eic/epic-data/onnx/identity_gemm_w1x1_b1.onnx.png

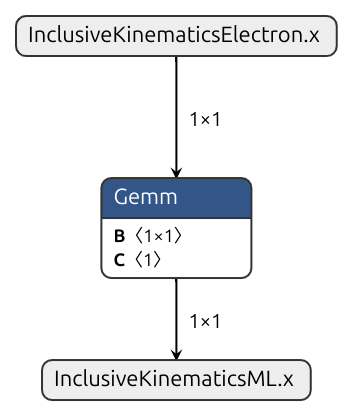
onnx/identity_gemm_w1x1_b1.onnx.png
