eic/epic-data/barrel_HCAL_gdml/ePIC_BarrelHCAL_Full_NoCombs_preMesh.FCStd

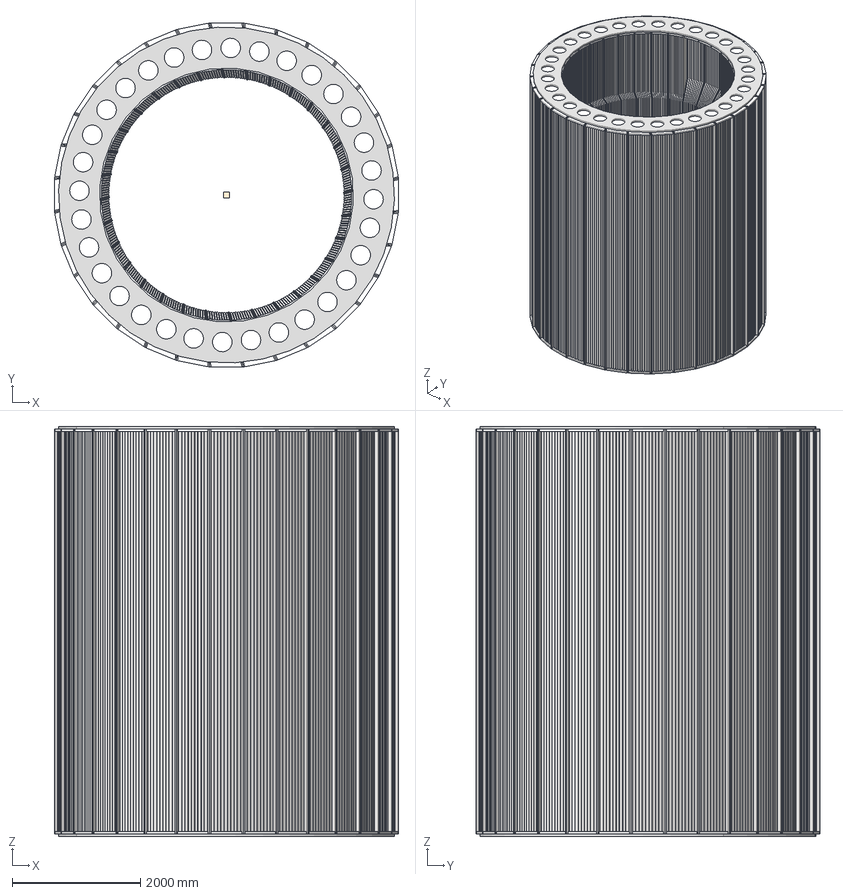
[picture p2: CAD file, 2024-01-17]
barrel_HCAL_gdml/ePIC_BarrelHCAL_Full_NoCombs_preMesh.FCStd
5364.5 x 5364.5 x 6393.4 mm
GDMLBox_WorldBox
Outer HCal Absorber Plate_Mod.stp.STEP
Outer HCal Absorber Plate_Mod.stp.STEP001
Outer HCal Absorber Plate_Mod.stp.STEP002
Outer HCal Absorber Plate_Mod.stp.STEP003
Outer HCal Absorber Plate_Mod.stp.STEP004
Outer HCal Absorber Plate_Mod.stp.STEP005
Outer HCal Absorber Plate_Mod.stp.STEP006
Outer HCal Absorber Plate_Mod.stp.STEP007
Outer HCal Absorber Plate_Mod.stp.STEP008
Outer HCal Half Absorber Plate A_Mod.stp.STEP
Outer HCal Half Absorber Plate B_Mod.stp.STEP
Outer HCal End Plate A_Mod.stp.STEP
Outer HCal End Plate B_Mod.stp.STEP
Outer HCal Absorber Plate_Mod.stp.STEP009
Outer HCal Absorber Plate_Mod.stp.STEP010
Outer HCal Absorber Plate_Mod.stp.STEP011
Outer HCal Absorber Plate_Mod.stp.STEP012
Outer HCal Absorber Plate_Mod.stp.STEP013
Outer HCal Absorber Plate_Mod.stp.STEP014
Outer HCal Absorber Plate_Mod.stp.STEP015
Outer HCal Absorber Plate_Mod.stp.STEP016
Outer HCal Absorber Plate_Mod.stp.STEP017
Outer HCal Half Absorber Plate A_Mod.stp.STEP001
Outer HCal Half Absorber Plate B_Mod.stp.STEP001
Outer HCal End Plate A_Mod.stp.STEP001
Outer HCal End Plate B_Mod.stp.STEP001
Outer HCal Absorber Plate_Mod.stp.STEP018
Outer HCal Absorber Plate_Mod.stp.STEP019
Outer HCal Absorber Plate_Mod.stp.STEP020
Outer HCal Absorber Plate_Mod.stp.STEP021
Outer HCal Absorber Plate_Mod.stp.STEP022
Outer HCal Absorber Plate_Mod.stp.STEP023
Outer HCal Absorber Plate_Mod.stp.STEP024
Outer HCal Absorber Plate_Mod.stp.STEP025
Outer HCal Absorber Plate_Mod.stp.STEP026
Outer HCal Half Absorber Plate A_Mod.stp.STEP002
Outer HCal Half Absorber Plate B_Mod.stp.STEP002
Outer HCal End Plate A_Mod.stp.STEP002
Outer HCal End Plate B_Mod.stp.STEP002
Outer HCal Absorber Plate_Mod.stp.STEP027
Outer HCal Absorber Plate_Mod.stp.STEP028
Outer HCal Absorber Plate_Mod.stp.STEP029
Outer HCal Absorber Plate_Mod.stp.STEP030
Outer HCal Absorber Plate_Mod.stp.STEP031
Outer HCal Absorber Plate_Mod.stp.STEP032
Outer HCal Absorber Plate_Mod.stp.STEP033
Outer HCal Absorber Plate_Mod.stp.STEP034
Outer HCal Absorber Plate_Mod.stp.STEP035
Outer HCal Half Absorber Plate A_Mod.stp.STEP003
Outer HCal Half Absorber Plate B_Mod.stp.STEP003
Outer HCal End Plate A_Mod.stp.STEP003
Outer HCal End Plate B_Mod.stp.STEP003
Outer HCal Absorber Plate_Mod.stp.STEP036
Outer HCal Absorber Plate_Mod.stp.STEP037
Outer HCal Absorber Plate_Mod.stp.STEP038
Outer HCal Absorber Plate_Mod.stp.STEP039
Outer HCal Absorber Plate_Mod.stp.STEP040
Outer HCal Absorber Plate_Mod.stp.STEP041
Outer HCal Absorber Plate_Mod.stp.STEP042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
