eic/epic-data/barrel_HCAL_gdml/ePIC_BarrelHCAL_Sector_NoCombs_Union_preMesh.FCStd

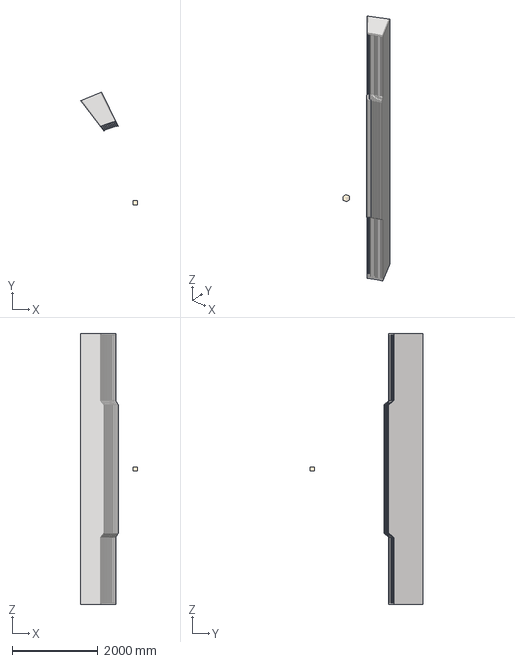
[picture p4: CAD file, 2024-02-16]
barrel_HCAL_gdml/ePIC_BarrelHCAL_Sector_NoCombs_Union_preMesh.FCStd
1319.6 x 2628.8 x 6316.2 mm
GDMLBox_WorldBox
