eic/epic-data/SVTOB_gdml/L3/2026-01-14_L3_Stave_for_Sims.step

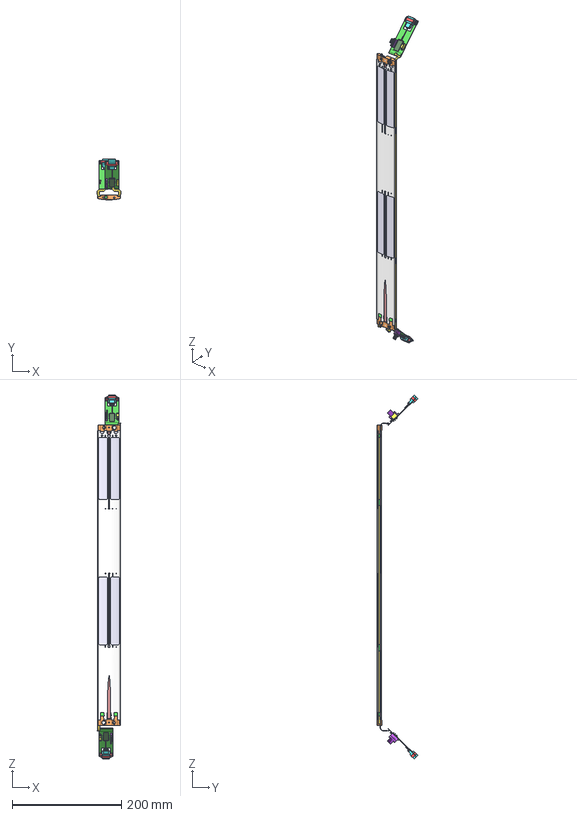
[picture p6: CAD file, 2026-10-30]
SVTOB_gdml/L3/2026-01-14_L3_Stave_for_Sims.step
44.2 x 74.6 x 666.2 mm
Carbon Compsite Central Spar_L3 x 2
K9 Split CrossBrace_L3 End x 2
K9 Split CrossBrace_L3 x 4
K9 Split CrossBrace_Sensor 4-077 x 2
MirrorK9 Split CrossBrace1_L3 End
Ultem End Mount_Square_Captive_Mod for C channel Longeron072 x 2
MirrorK9 Split CrossBrace2_L3 End
FPC Mockup L3_L3 Full x 2
Carbon Composite Stave Skin L3_updated_Bottom
Carbon Composite Stave Skin L3_updated_Top
CAPC0603X33N_3.step x 2
CAPC0603X33N001_3.step x 2
CAPC0603X33N002_3.step x 2
CAPC0603X33N004_2.step x 2
CAPC0603X33N005_3.step x 2
CAPC0603X33N006_2.step x 2
CAPC0603X33N008_3.step x 2
CAPC0603X33N009_3.step x 2
CAPC0603X33N010_3.step x 2
CAPC0603X33N012_2.step x 2
CAPC0603X33N013_3.step x 2
CAPC0603X33N014_3.step x 2
RESC0603X28N_3.step x 2
RESC0603X28N001_3.step x 2
RESC0603X28N002_3.step x 2
CAPC0603X33N016_3.step x 2
CAPC0603X33N017_2.step x 2
CAPC0603X33N018_3.step x 2
CAPC0603X33N020_3.step x 2
CAPC0603X33N021_3.step x 2
CAPC0603X33N022_3.step x 2
CAPC0603X33N024_3.step x 2
CAPC0603X33N025_3.step x 2
CAPC0603X33N026_3.step x 2
DF40C-40DP_3.step x 2
CAPC1005X55N_3.step x 2
CAPC1005X55N001_3.step x 2
CAPC1005X55N002_3.step x 2
CAPC1005X55N004_3.step x 2
CAPC1005X55N005_3.step x 2
CAPC1005X55N006_3.step x 2
CAPC0603X33N028_3.step x 2
CAPC0603X33N029_3.step x 2
CAPC0603X33N030_3.step x 2
CAPC0603X33N032_3.step x 2
CAPC0603X33N033_3.step x 2
CAPC0603X33N034_3.step x 2
CAPC0603X33N036_3.step x 2
CAPC0603X33N037_3.step x 2
CAPC0603X33N038_3.step x 2
CAPC1005X55N008_3.step x 2
CAPC1005X55N009_3.step x 2
CAPC1005X55N010_3.step x 2
Board_3.step x 2
Opto_3.step x 2
Pigtail_3.step x 2
Pigtail001_3.step x 2
Pigtail002_3.step x 2
Pigtail003_3.step x 2
Pigtail004_3.step x 2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
