eic/epic-data/barrel_HCAL_gdml/ePIC_BarrelHCAL_Sector_NoCombs_Union_Meshed.FCStd

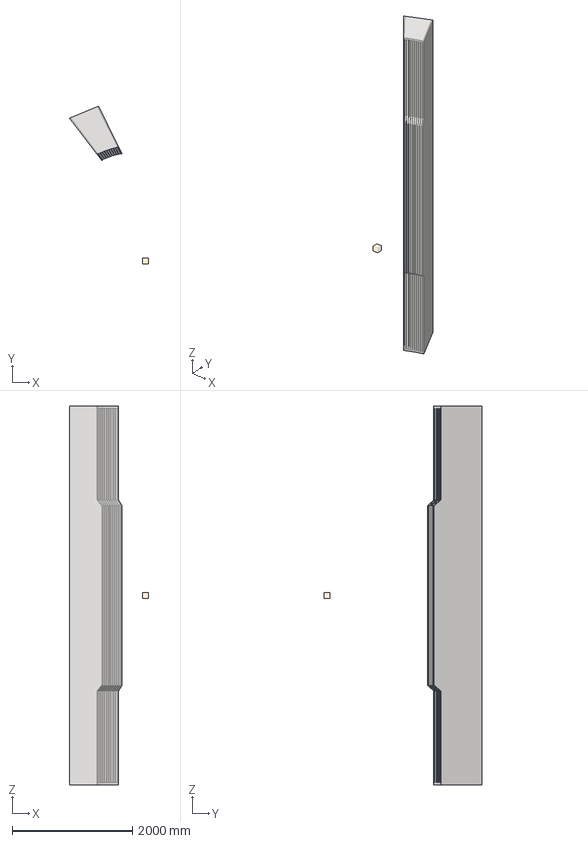
[picture p7: CAD file, 2024-02-16]
barrel_HCAL_gdml/ePIC_BarrelHCAL_Sector_NoCombs_Union_Meshed.FCStd
1319.6 x 2628.8 x 6316.2 mm
GDMLBox_WorldBox
GDMLTessellate_Mesh2Tess
