eic/epic-data/barrel_HCAL_gdml/tiles/Outer HCAL Tile 6 Fiber - South 10-20-2022.stp

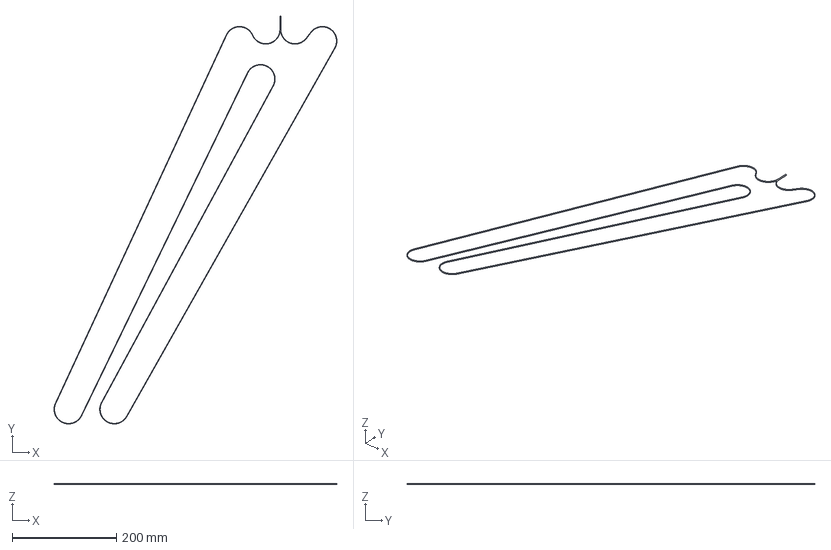
[picture p8: CAD file, 2024-02-11]
barrel_HCAL_gdml/tiles/Outer HCAL Tile 6 Fiber - South 10-20-2022.stp
542.7 x 782.3 x 2.10 mm
