eic/epic-data/barrel_HCAL_gdml/ePIC_BarrelHCAL_ChimneySector_NoCombs_Union_preMesh.FCStd

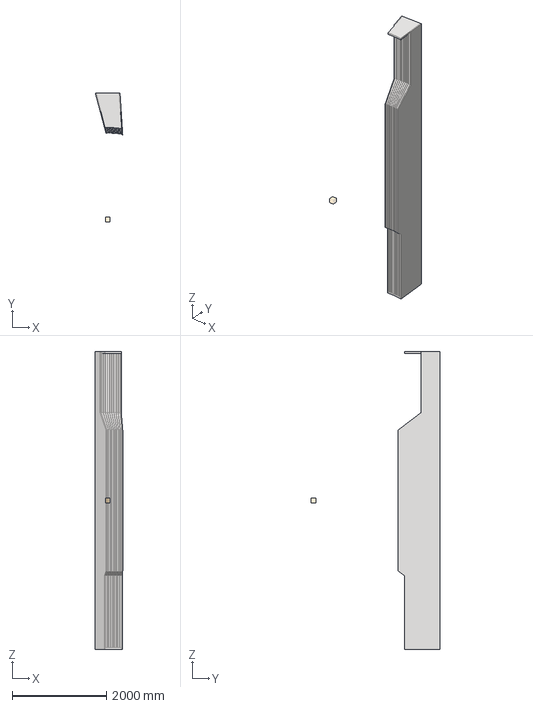
[picture p9: CAD file, 2024-02-16]
barrel_HCAL_gdml/ePIC_BarrelHCAL_ChimneySector_NoCombs_Union_preMesh.FCStd
583.6 x 2732.3 x 6316.2 mm
GDMLBox_WorldBox
