eic/epic-data/barrel_HCAL_gdml/tiles/Outer HCAL Tile 2 Fiber - South10-19-2022.stp

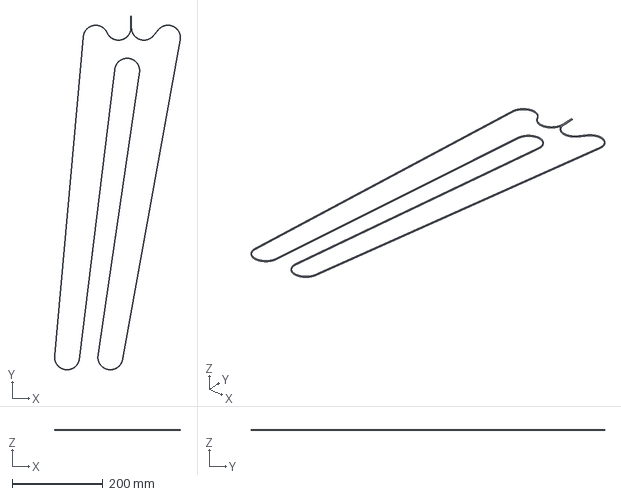
[picture p10: CAD file, 2024-02-11]
barrel_HCAL_gdml/tiles/Outer HCAL Tile 2 Fiber - South10-19-2022.stp
279.0 x 782.3 x 2.10 mm
