eic/epic-data/barrel_HCAL_gdml/2021MAY12_sPHENIX_CM_ChimneySector_NoCombs.STEP

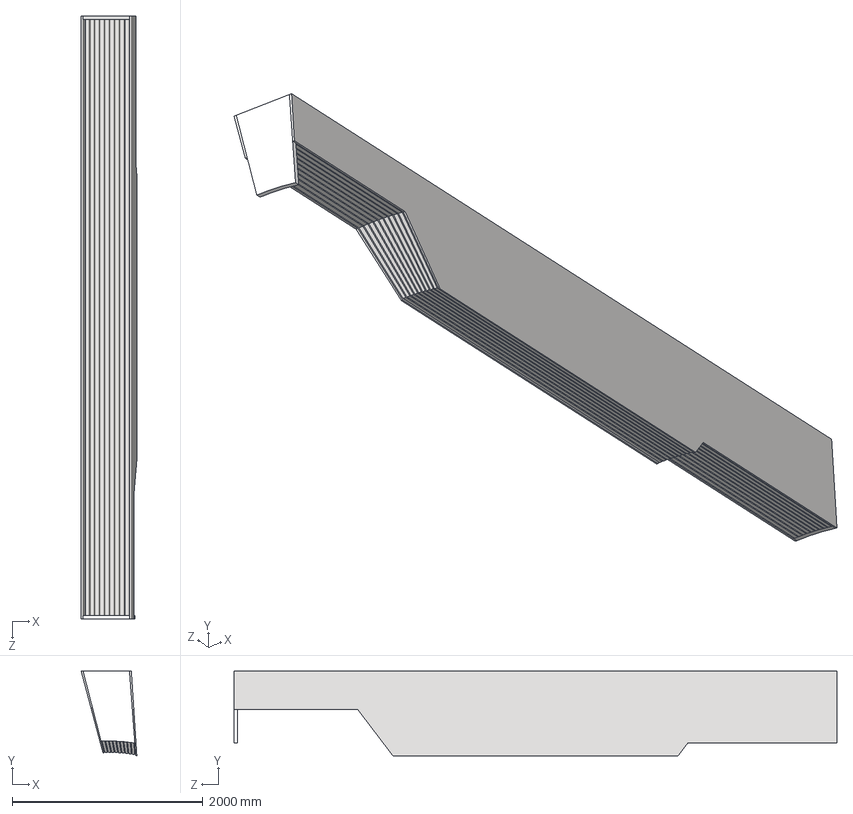
[picture p11: CAD file, 2024-02-16]
barrel_HCAL_gdml/2021MAY12_sPHENIX_CM_ChimneySector_NoCombs.STEP
583.6 x 886.5 x 6316.2 mm
Chimney HCal Absorber Plate_Mod.stp.STEP.STEP x 9
Chimney HCal Half Absorber Plate A_Mod.stp.STEP.STEP
Chimney HCal Half Absorber Plate B_Mod.stp.STEP.STEP
Outer HCal End Plate A_Mod.stp.STEP.STEP
Outer HCal End Plate B_Mod.stp.STEP.STEP
