eic/epic-data/barrel_HCAL_gdml/2021MAY12_sPHENIX_CM_Sector_NoCombs.STEP

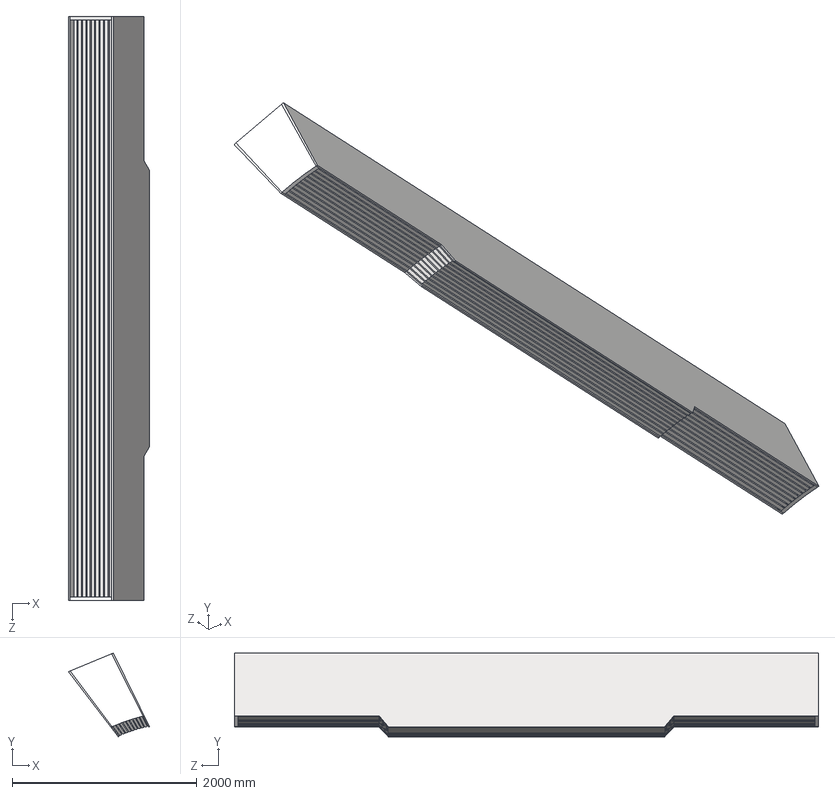
[picture p13: CAD file, 2024-02-16]
barrel_HCAL_gdml/2021MAY12_sPHENIX_CM_Sector_NoCombs.STEP
878.4 x 906.8 x 6316.2 mm
Outer HCal Absorber Plate_Mod.stp.STEP.STEP x 9
Outer HCal Half Absorber Plate A_Mod.stp.STEP.STEP
Outer HCal Half Absorber Plate B_Mod.stp.STEP.STEP
Outer HCal End Plate A_Mod.stp.STEP.STEP
Outer HCal End Plate B_Mod.stp.STEP.STEP
