eic/epic-data/barrel_HCAL_gdml/tiles/Outer HCAL Chimney Tile 11  Fiber  - South 10-20-2022.stp

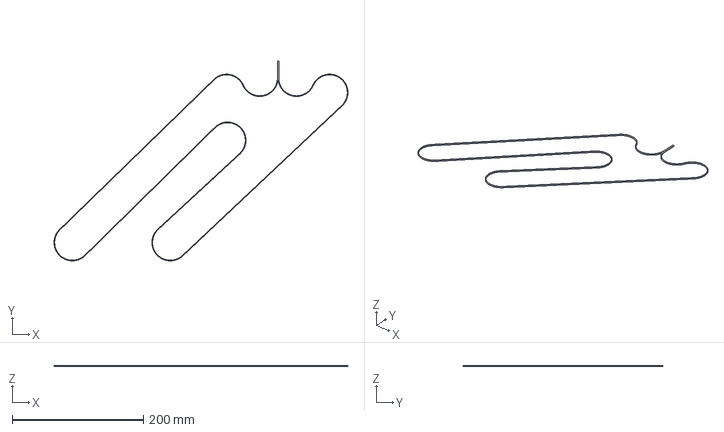
[picture p14: CAD file, 2024-02-11]
barrel_HCAL_gdml/tiles/Outer HCAL Chimney Tile 11 Fiber - South 10-20-2022.stp
448.2 x 304.7 x 2.10 mm
