eic/epic-data/barrel_HCAL_gdml/tiles/Outer HCAL Tile 1 Body  - North10-19-2022.stp

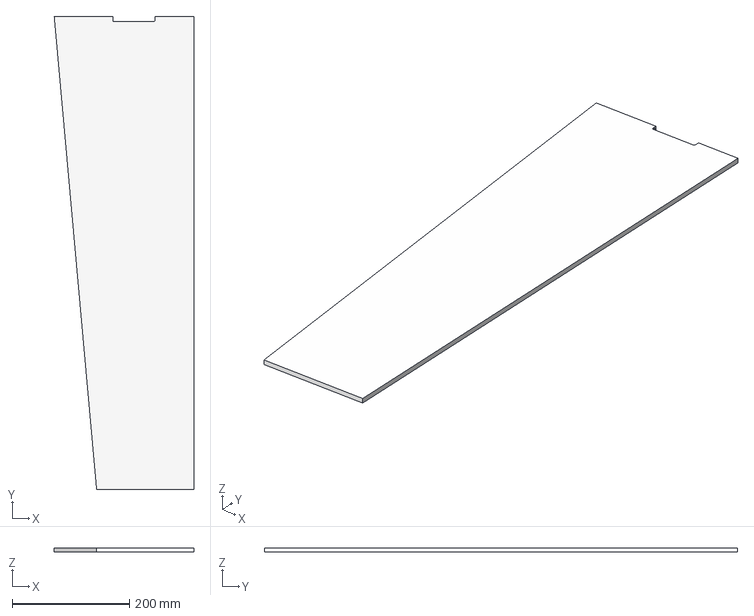
[picture p15: CAD file, 2024-02-11]
barrel_HCAL_gdml/tiles/Outer HCAL Tile 1 Body - North10-19-2022.stp
238.5 x 808.3 x 7.00 mm
