eic/epic-data/barrel_HCAL_gdml/ePIC_BarrelHCAL_EndRing_preMesh.FCStd

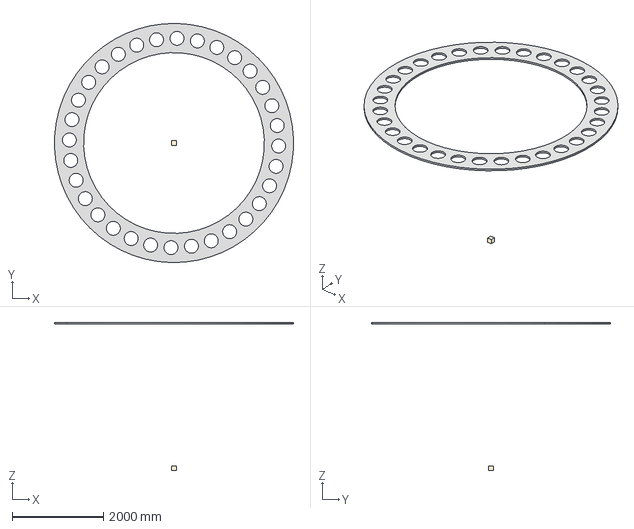
[picture p16: CAD file, 2024-02-16]
barrel_HCAL_gdml/ePIC_BarrelHCAL_EndRing_preMesh.FCStd
5236.9 x 5238.5 x 3247.7 mm
GDMLBox_WorldBox
SIMPL_RING_1.stp.STEP.STEP
