eic/epic-data/barrel_HCAL_gdml/tiles/Outer HCAL Tile 5 Body - North10-20-2022.stp

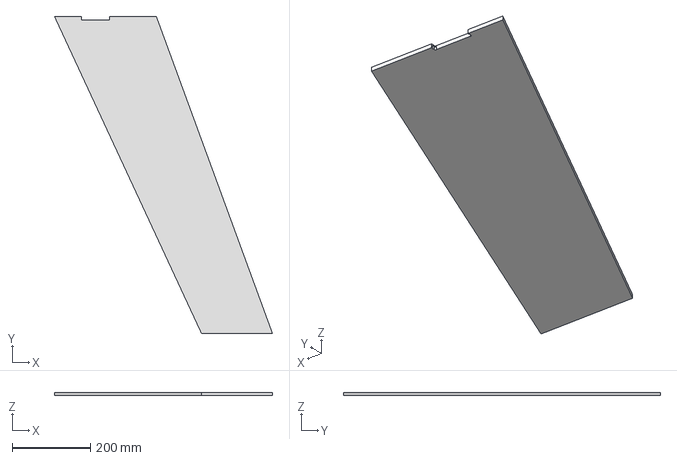
[picture p17: CAD file, 2024-02-11]
barrel_HCAL_gdml/tiles/Outer HCAL Tile 5 Body - North10-20-2022.stp
556.0 x 808.3 x 7.00 mm
