eic/epic-data/barrel_HCAL_gdml/tiles/Outer HCAL Tile 3 Fiber  - North10-20-2022.stp

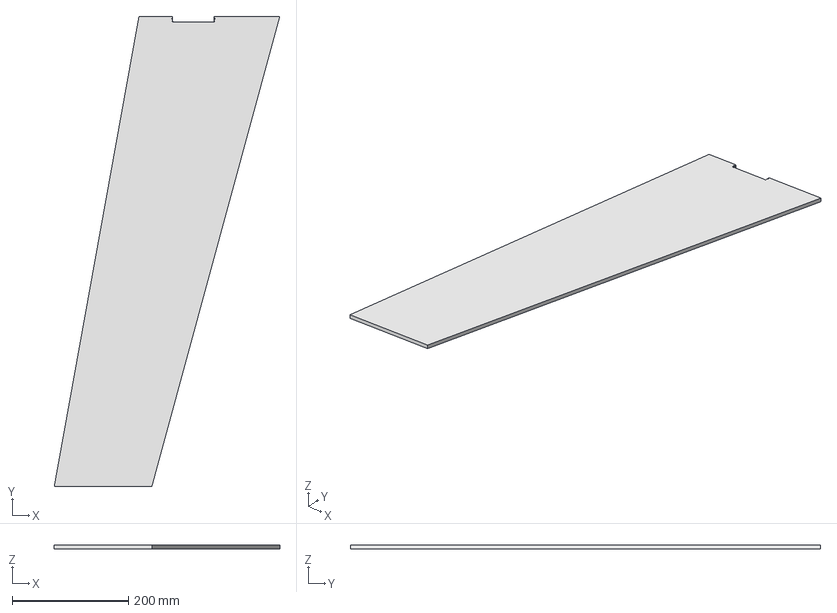
[picture p19: CAD file, 2024-02-11]
barrel_HCAL_gdml/tiles/Outer HCAL Tile 3 Fiber - North10-20-2022.stp
387.9 x 808.3 x 7.00 mm
