eic/epic-data/barrel_HCAL_gdml/tiles/Outer HCAL Tile 10  Fiber  - North10-20-2022.stp

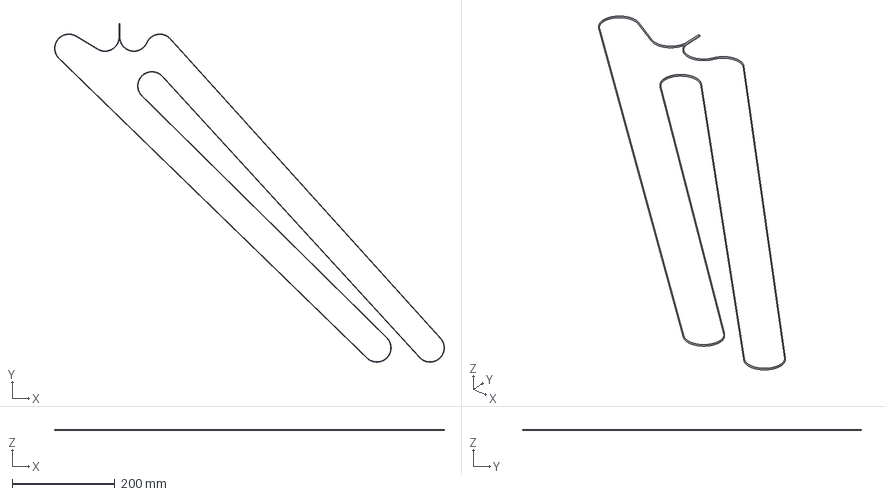
[picture p20: CAD file, 2024-02-11]
barrel_HCAL_gdml/tiles/Outer HCAL Tile 10 Fiber - North10-20-2022.stp
758.4 x 658.4 x 2.10 mm
