eic/epic-data/barrel_HCAL_gdml/2021MAY12_sPHENIX_CM_EndRing.STEP

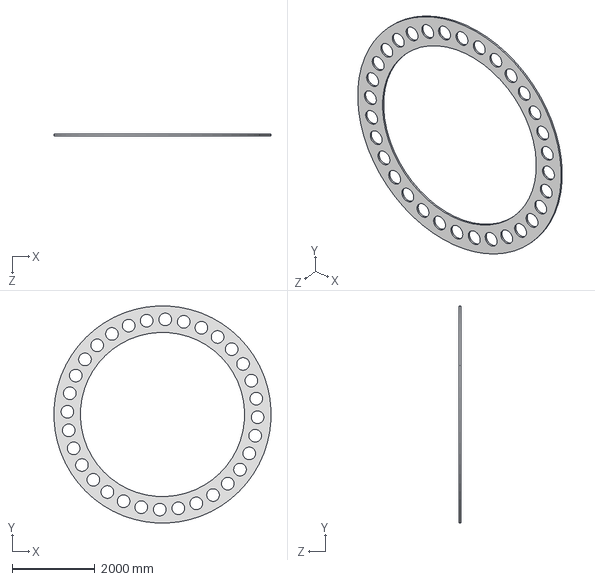
[picture p21: CAD file, 2024-02-16]
barrel_HCAL_gdml/2021MAY12_sPHENIX_CM_EndRing.STEP
5233.9 x 5233.9 x 38.6 mm
