eic/epic-data/barrel_HCAL_gdml/tiles/Outer HCAL Tile 12  Fiber  - North10-20-2022.stp

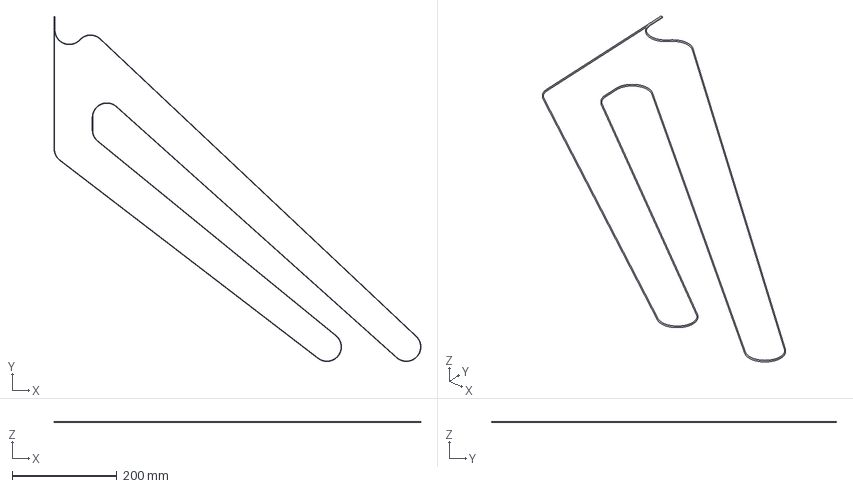
[picture p22: CAD file, 2024-02-11]
barrel_HCAL_gdml/tiles/Outer HCAL Tile 12 Fiber - North10-20-2022.stp
700.1 x 658.4 x 2.10 mm
