eic/epic-data/barrel_HCAL_gdml/ePIC_BarrelHCAL_Plates_EndPlates_Only_Union_preMesh.FCStd

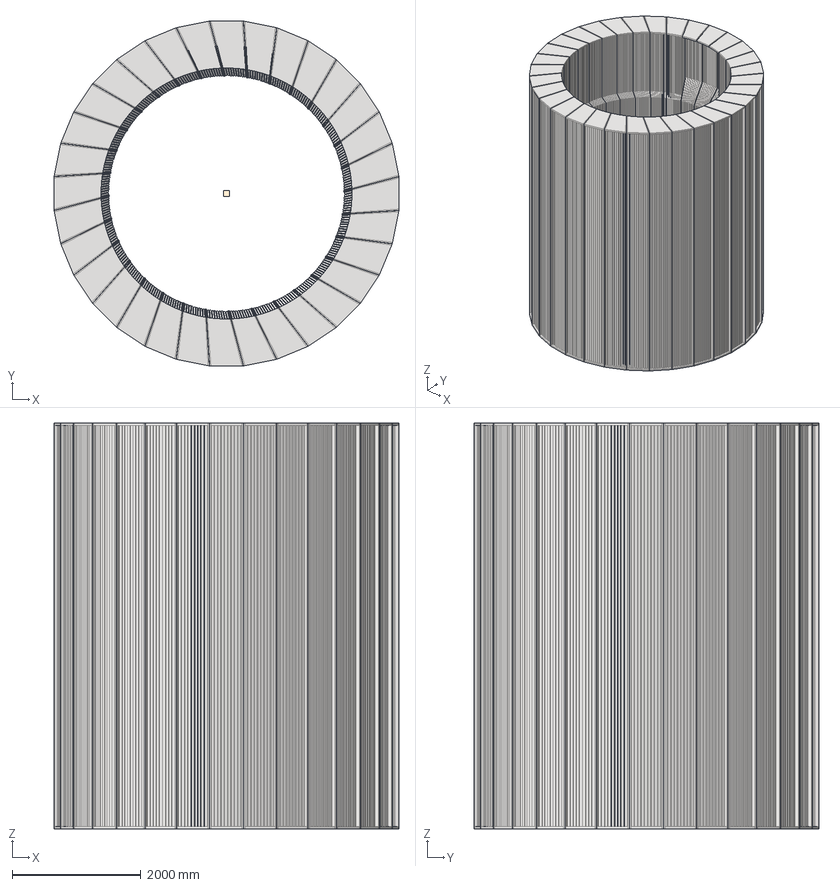
[picture p23: CAD file, 2024-01-17]
barrel_HCAL_gdml/ePIC_BarrelHCAL_Plates_EndPlates_Only_Union_preMesh.FCStd
5364.5 x 5364.5 x 6316.2 mm
GDMLBox_WorldBox
