eic/epic-data/barrel_HCAL_gdml/tiles/Outer HCAL Tile 9  Body - North10-20-2022.stp

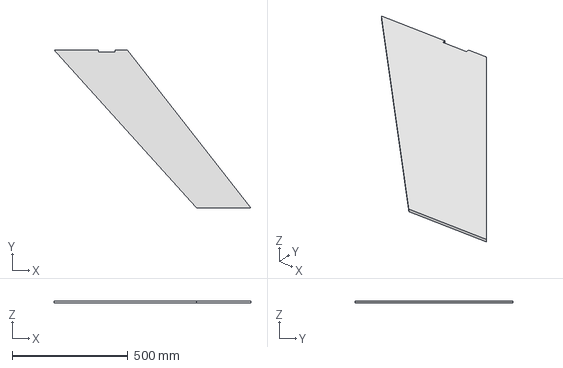
[picture p25: CAD file, 2024-02-11]
barrel_HCAL_gdml/tiles/Outer HCAL Tile 9 Body - North10-20-2022.stp
852.3 x 684.4 x 7.00 mm
