eic/epic-data/barrel_HCAL_gdml/tiles/Outer HCAL Tile 4 Fiber  - North10-20-2022.stp

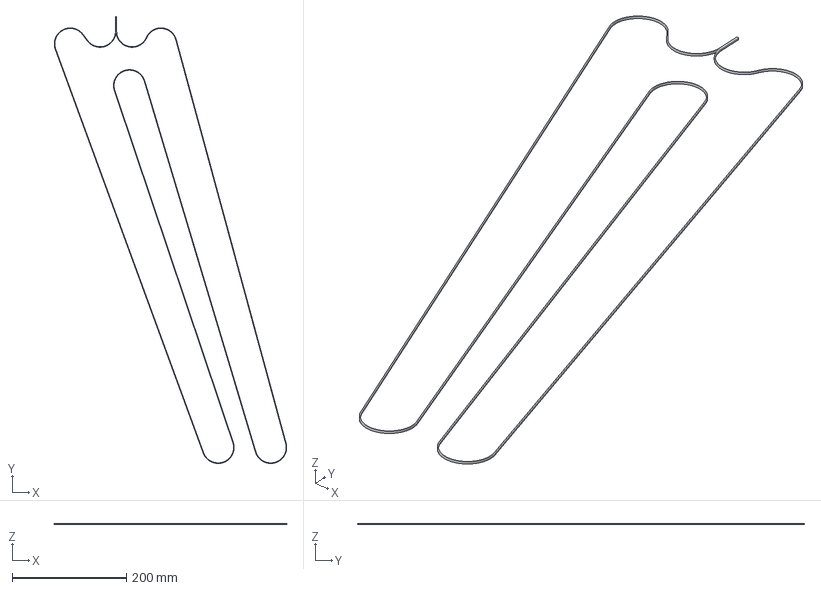
[picture p26: CAD file, 2024-02-11]
barrel_HCAL_gdml/tiles/Outer HCAL Tile 4 Fiber - North10-20-2022.stp
406.9 x 782.3 x 2.10 mm
