eic/epic-data/barrel_HCAL_gdml/tiles/Outer HCAL Tile 2 Body  - North10-19-2022.stp

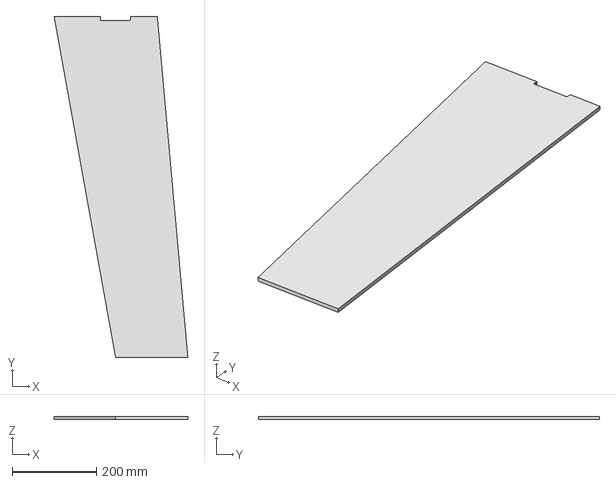
[picture p27: CAD file, 2024-02-11]
barrel_HCAL_gdml/tiles/Outer HCAL Tile 2 Body - North10-19-2022.stp
317.1 x 808.3 x 7.00 mm
