eic/epic-data/barrel_HCAL_gdml/tiles/Outer HCAL Tile 7  Fiber  - South 10-20-2022.stp

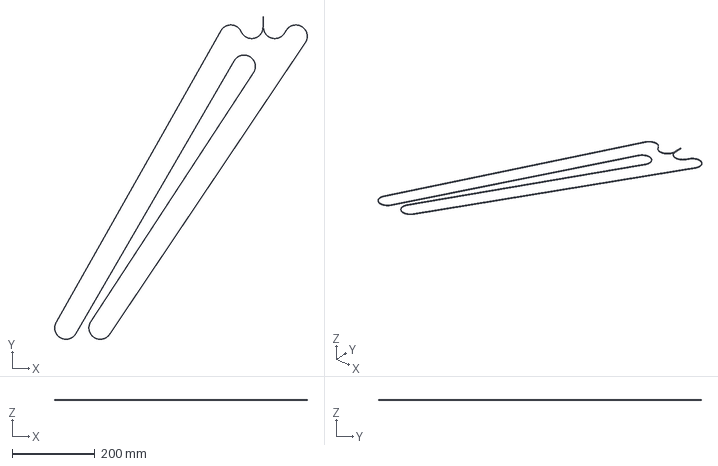
[picture p30: CAD file, 2024-02-11]
barrel_HCAL_gdml/tiles/Outer HCAL Tile 7 Fiber - South 10-20-2022.stp
612.8 x 782.3 x 2.10 mm
