eic/epic-data/barrel_HCAL_gdml/tiles/Outer HCAL Tile 8  Body - North10-20-2022.stp

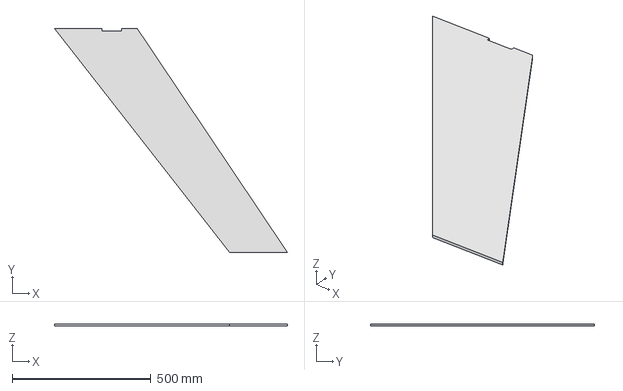
[picture p33: CAD file, 2024-02-11]
barrel_HCAL_gdml/tiles/Outer HCAL Tile 8 Body - North10-20-2022.stp
841.0 x 808.3 x 7.00 mm
