eic/epic-data/barrel_HCAL_gdml/2021MAY12_sPHENIX_CM_Plates_EndPlates_Only.STEP

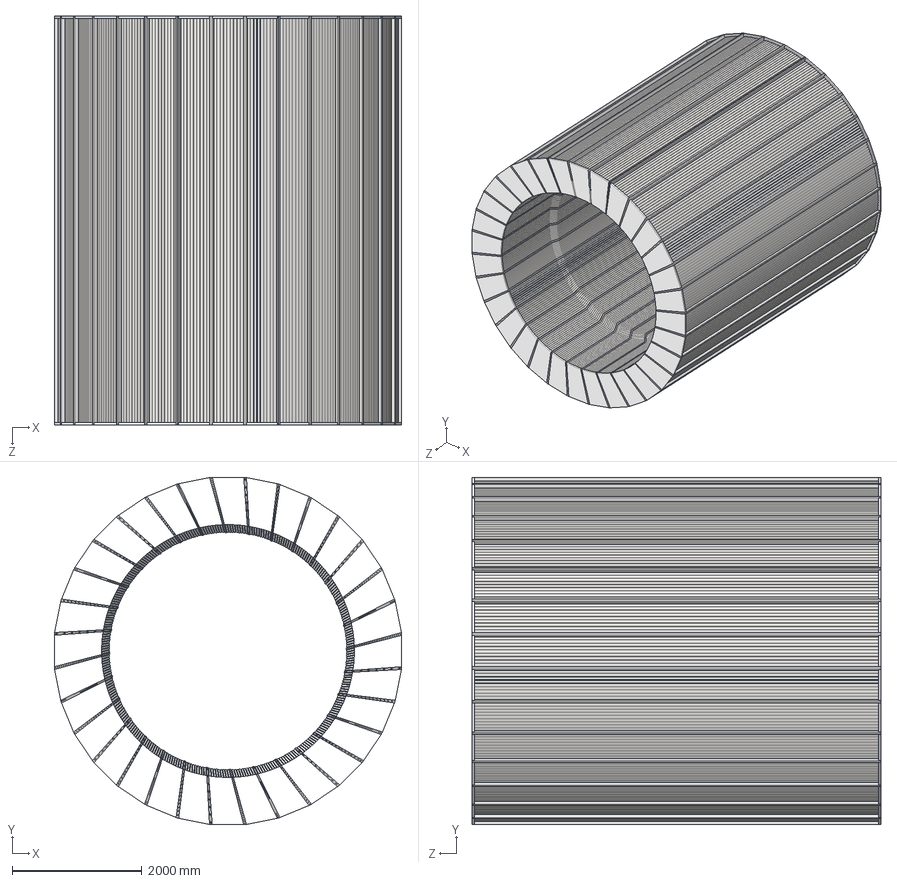
[picture p34: CAD file, 2024-01-04]
barrel_HCAL_gdml/2021MAY12_sPHENIX_CM_Plates_EndPlates_Only.STEP
5364.5 x 5364.5 x 6316.2 mm
Outer HCal Absorber Plate_Mod.stp.STEP x 261
Outer HCal Half Absorber Plate A_Mod.stp.STEP x 29
Outer HCal Half Absorber Plate B_Mod.stp.STEP x 29
Outer HCal End Plate A_Mod.stp.STEP x 32
Outer HCal End Plate B_Mod.stp.STEP x 32
Chimney HCal Absorber Plate_Mod.stp.STEP x 27
Chimney HCal Half Absorber Plate A_Mod.stp.STEP x 3
Chimney HCal Half Absorber Plate B_Mod.stp.STEP x 3
