eic/epic-data/barrel_HCAL_gdml/tiles/Outer HCAL Tile 9  Fiber  - North10-20-2022.stp

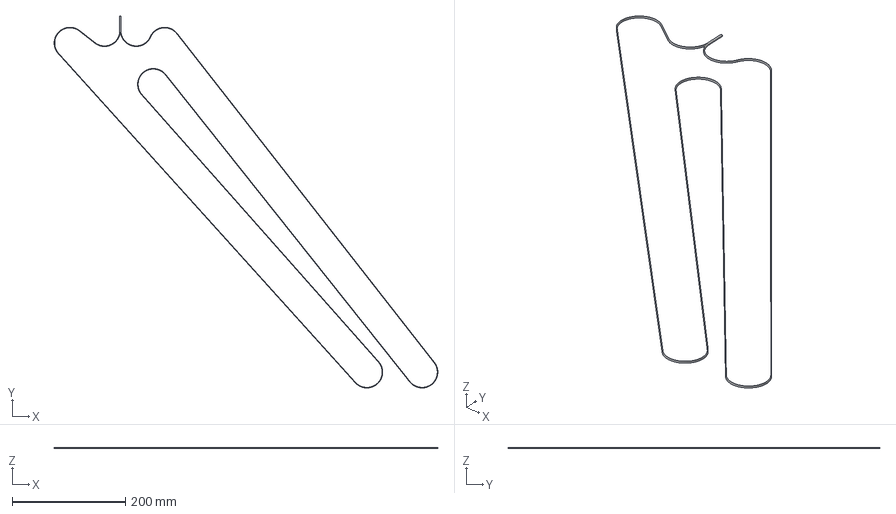
[picture p35: CAD file, 2024-02-11]
barrel_HCAL_gdml/tiles/Outer HCAL Tile 9 Fiber - North10-20-2022.stp
679.2 x 658.4 x 2.10 mm
