eic/epic-data/barrel_HCAL_gdml/tiles/Outer HCAL Tile 10  Body - North10-20-2022.stp

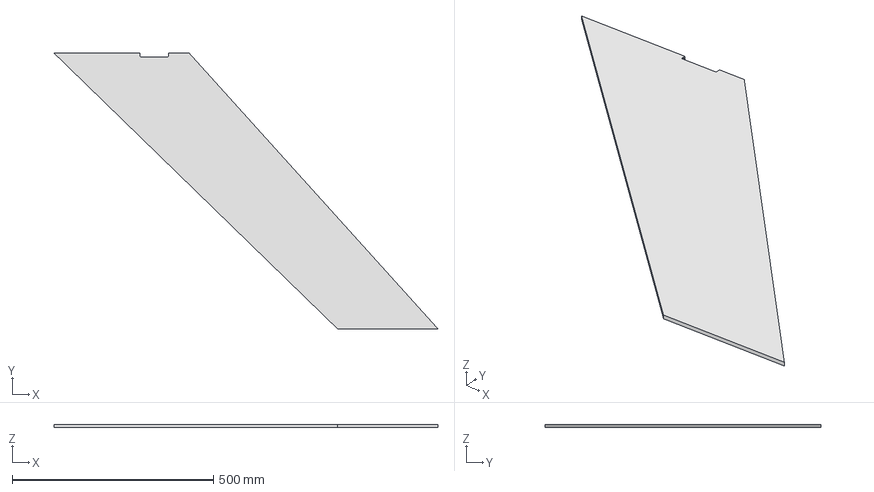
[picture p36: CAD file, 2024-02-11]
barrel_HCAL_gdml/tiles/Outer HCAL Tile 10 Body - North10-20-2022.stp
953.1 x 684.4 x 7.00 mm
