eic/epic-data/barrel_HCAL_gdml/tiles/Outer HCAL Chimney Tile 9  Body - South 10-20-2022.stp

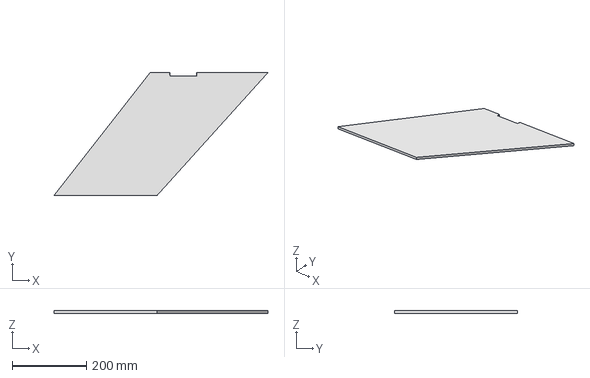
[picture p37: CAD file, 2024-02-11]
barrel_HCAL_gdml/tiles/Outer HCAL Chimney Tile 9 Body - South 10-20-2022.stp
575.7 x 330.7 x 7.00 mm
