eic/epic-data/barrel_HCAL_gdml/tiles/Outer HCAL Chimney Tile 12  Fiber  - South 10-20-2022.stp

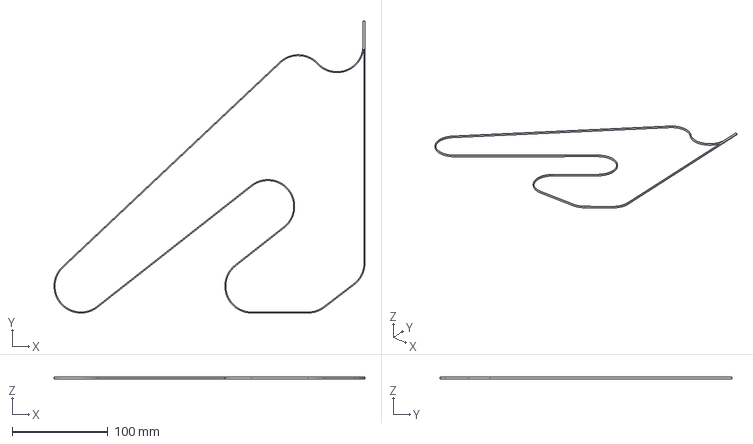
[picture p38: CAD file, 2024-02-11]
barrel_HCAL_gdml/tiles/Outer HCAL Chimney Tile 12 Fiber - South 10-20-2022.stp
324.3 x 304.7 x 2.10 mm
