eic/epic-data/barrel_HCAL_gdml/tiles/Outer HCAL Tile 3 Fiber - South 10-20-2022.stp

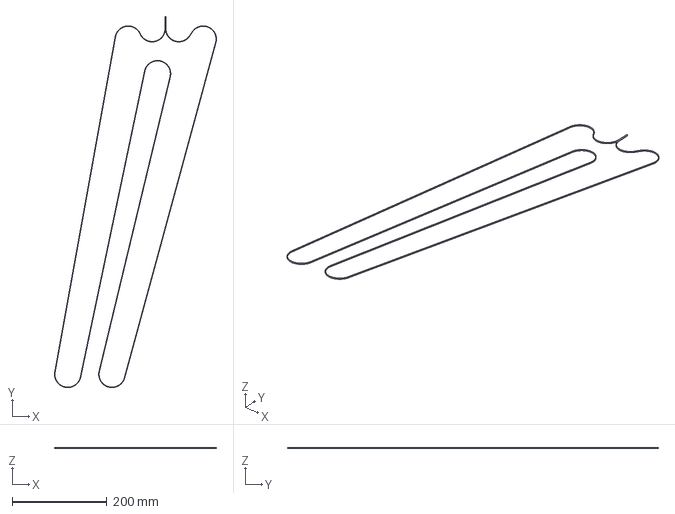
[picture p40: CAD file, 2024-02-11]
barrel_HCAL_gdml/tiles/Outer HCAL Tile 3 Fiber - South 10-20-2022.stp
341.3 x 782.3 x 2.10 mm
