eic/epic-data/barrel_HCAL_gdml/tiles/Outer HCAL Tile 1 Fiber  - South 10-20-2022.stp

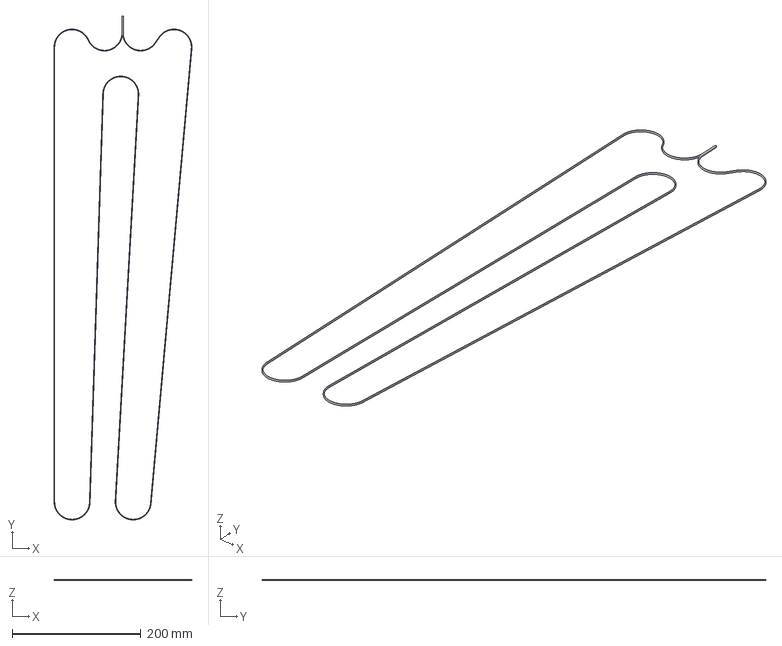
[picture p41: CAD file, 2024-02-11]
barrel_HCAL_gdml/tiles/Outer HCAL Tile 1 Fiber - South 10-20-2022.stp
214.3 x 782.7 x 2.10 mm
