eic/epic-data/barrel_HCAL_gdml/tiles/Outer HCAL Tile 11  Fiber  - North10-20-2022.stp

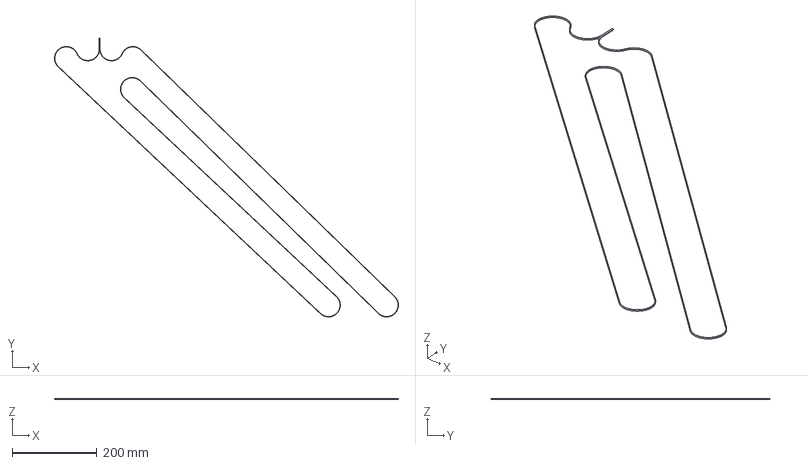
[picture p42: CAD file, 2024-02-11]
barrel_HCAL_gdml/tiles/Outer HCAL Tile 11 Fiber - North10-20-2022.stp
811.9 x 658.4 x 2.10 mm
