eic/epic-data/barrel_HCAL_gdml/tiles/Outer HCAL Tile 12  Body - North10-20-2022.stp

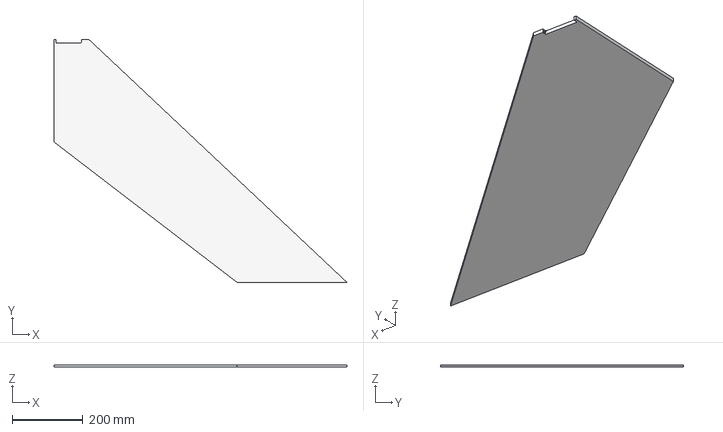
[picture p44: CAD file, 2024-02-11]
barrel_HCAL_gdml/tiles/Outer HCAL Tile 12 Body - North10-20-2022.stp
825.9 x 684.4 x 7.00 mm
