eic/epic-data/barrel_HCAL_gdml/tiles/Outer HCAL Chimney Tile 11  Body - South 10-20-2022.stp

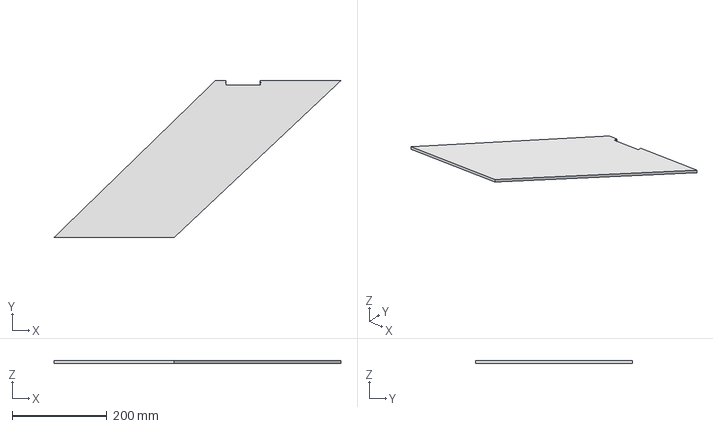
[picture p46: CAD file, 2024-02-11]
barrel_HCAL_gdml/tiles/Outer HCAL Chimney Tile 11 Body - South 10-20-2022.stp
604.7 x 330.7 x 7.00 mm
