eic/epic-data/barrel_HCAL_gdml/tiles/Outer HCAL Chimney Tile 9  Fiber  - South 10-20-2022.stp

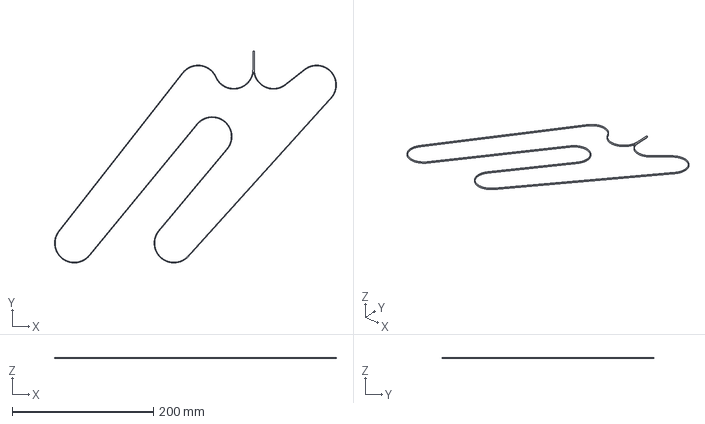
[picture p47: CAD file, 2024-02-11]
barrel_HCAL_gdml/tiles/Outer HCAL Chimney Tile 9 Fiber - South 10-20-2022.stp
398.7 x 299.7 x 2.10 mm
