eic/epic-data/barrel_HCAL_gdml/tiles/Outer HCAL Tile 7  Body  - South 10-20-2022.stp

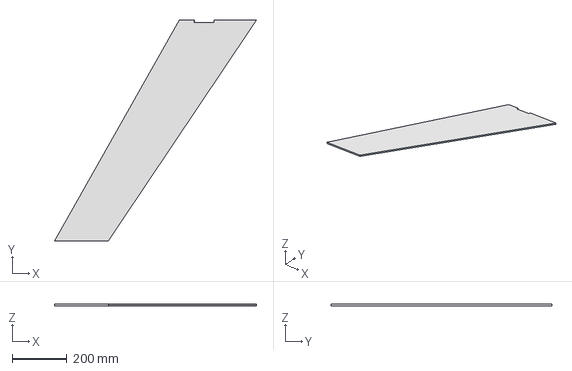
[picture p48: CAD file, 2024-02-11]
barrel_HCAL_gdml/tiles/Outer HCAL Tile 7 Body - South 10-20-2022.stp
739.2 x 808.3 x 7.00 mm
