eic/epic-data/(list of files, cad)

Other CAD files:
barrel_HCAL_gdml/2021MAY12_sPHENIX_CM_Full_NoCombs.STEP
barrel_HCAL_gdml/ePIC_BarrelHCAL_Full_NoCombs_Union_preMesh.FCStd
barrel_HCAL_gdml/ePIC_BarrelHCAL_Sector_NoCombs_preMesh.FCStd
barrel_HCAL_gdml/ePIC_BarrelHCAL_ChimneySector_NoCombs_preMesh.FCStd
barrel_HCAL_gdml/ePIC_BarrelHCAL_Plates_Only_preMesh.FCStd
barrel_HCAL_gdml/tiles/Outer HCAL Tile 3 Body - South 10-20-2022.stp
barrel_HCAL_gdml/2021MAY12_sPHENIX_CM_Plates_Only.STEP
barrel_HCAL_gdml/ePIC_BarrelHCAL_Plates_EndPlates_Only_preMesh.FCStd
barrel_HCAL_gdml/tiles/Outer HCAL Tile 7 Fiber - North10-20-2022.stp
barrel_HCAL_gdml/tiles/Outer HCAL Tile 5 Body - South 10-20-2022.stp
barrel_HCAL_gdml/tiles/Outer HCAL Tile 1 Body - South 10-20-2022.stp
barrel_HCAL_gdml/tiles/Outer HCAL Tile 6 Fiber - North10-20-2022.stp
barrel_HCAL_gdml/tiles/Outer HCAL Tile 2 Fiber - North10-19-2022.stp
barrel_HCAL_gdml/tiles/Outer HCAL Tile 6 Body - North10-20-2022.stp
barrel_HCAL_gdml/tiles/Outer HCAL Tile 4 Fiber - South 10-20-2022.stp
barrel_HCAL_gdml/tiles/Outer HCAL Tile 8 Body - South 10-20-2022.stp
barrel_HCAL_gdml/tiles/Outer HCAL Tile 2 Body - South10-19-2022.stp
barrel_HCAL_gdml/tiles/Outer HCAL Tile 5 Fiber - South 10-20-2022.stp
barrel_HCAL_gdml/tiles/Outer HCAL Tile 1 Fiber - North10-19-2022.stp
barrel_HCAL_gdml/tiles/Outer HCAL Tile 4 Body - South 10-20-2022.stp
barrel_HCAL_gdml/tiles/Outer HCAL Tile 8 Fiber - North10-20-2022.stp
barrel_HCAL_gdml/tiles/Outer HCAL Tile 7 Body - North10-20-2022.stp
barrel_HCAL_gdml/tiles/Outer HCAL Tile 3 Fiber - North10-20-2022.stp
