eic/epic-data/onnx/Low-Q2_Steering_Reconstruction.onnx.png

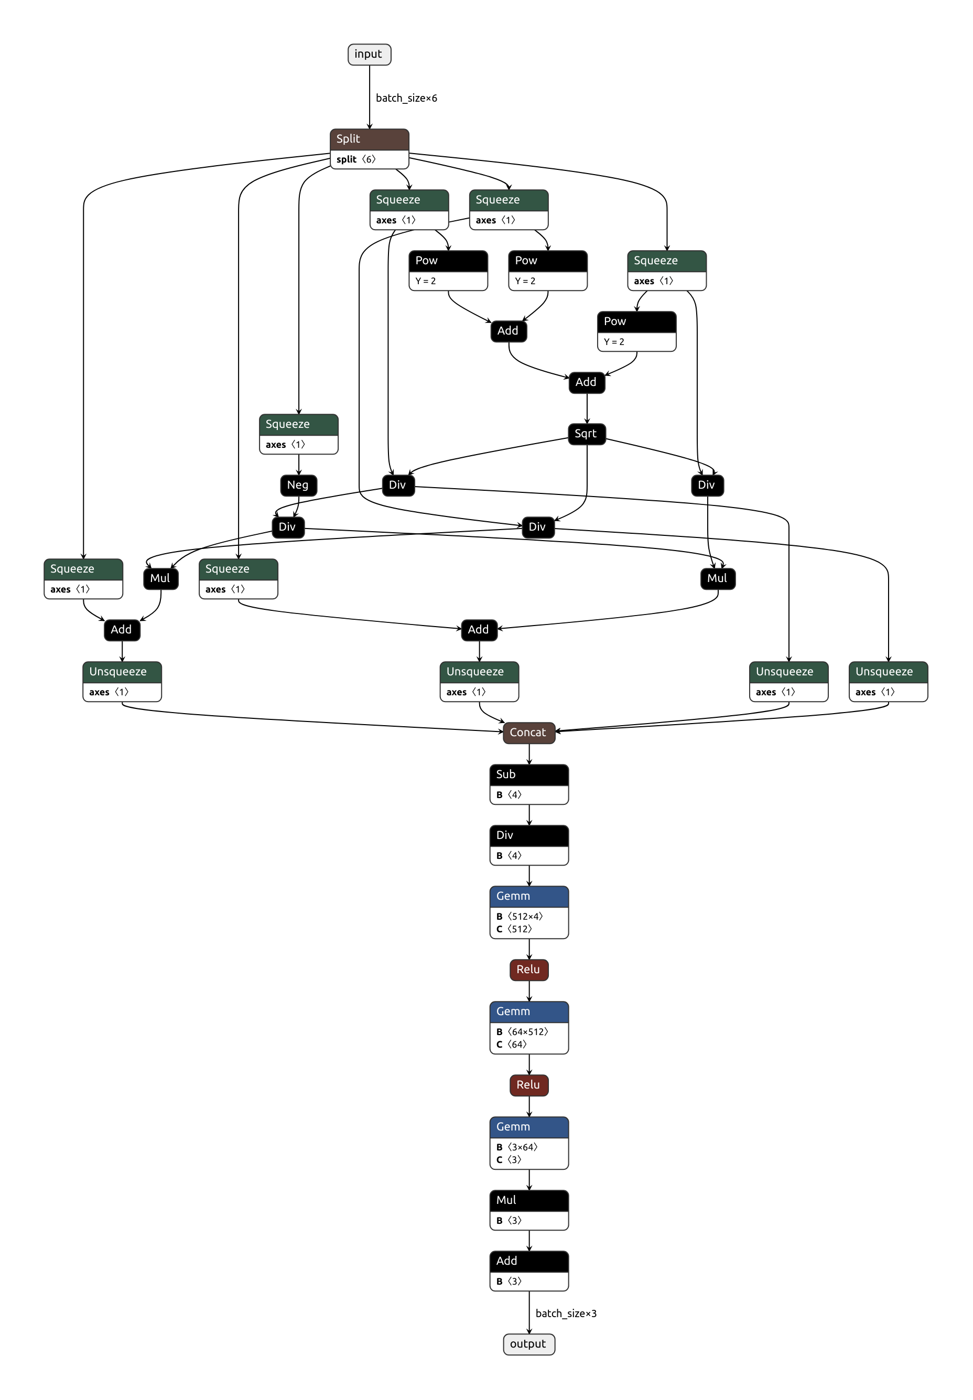
onnx/Low-Q2_Steering_Reconstruction.onnx.png
