eic/epic-data/(commit log)

2024-01-04 adding barrel HCAL STEP, FreeCAD and gdml files
    [ePIC_BarrelHCAL_preMesh.FCStd, sPHENIX_CM_Plates_EndPlates_Only.STEP]
2024-01-16 adding STEP files and FreeCAD projects
    [2021MAY12_sPHENIX_CM.STEP, 2021MAY12_sPHENIX_CM_Full.STEP, 2021MAY12_sPHENIX_CM_Full_NoCombs.STEP, 2021MAY12_sPHENIX_CM_Plates_EndPlates_Only.STEP, 2021MAY12_sPHENIX_CM_Plates_Only.STEP, ePIC_BarrelHCAL_Full_NoCombs_Union_preMesh.FCStd, ePIC_BarrelHCAL_Full_NoCombs_preMesh.FCStd, ePIC_BarrelHCAL_Plates_EndPlates_Only_Union_preMesh.FCStd]
2024-01-18 added tiles source files and reduced GDML
    [Outer HCAL Chimney Tile 10 Body - South 10-20-2022.stp, Outer HCAL Chimney Tile 10 Fiber - South 10-20-2022.stp, Outer HCAL Chimney Tile 11 Body - South 10-20-2022.stp, Outer HCAL Chimney Tile 11 Fiber - South 10-20-2022.stp, Outer HCAL Chimney Tile 12 Body - South 10-20-2022.stp, Outer HCAL Chimney Tile 12 Fiber - South 10-20-2022.stp, Outer HCAL Chimney Tile 9 Body - South 10-20-2022.stp, Outer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]
2024-02-16 added barrel components, updated README
    [2021MAY12_sPHENIX_CM_ChimneySector_NoCombs.STEP, 2021MAY12_sPHENIX_CM_EndRing.STEP, 2021MAY12_sPHENIX_CM_Sector_NoCombs.STEP, ePIC_BarrelHCAL_ChimneySector_NoCombs_Union_Meshed.FCStd, ePIC_BarrelHCAL_ChimneySector_NoCombs_Union_preMesh.FCStd, ePIC_BarrelHCAL_ChimneySector_NoCombs_preMesh.FCStd, ePIC_BarrelHCAL_EndRing_preMesh.FCStd, ePIC_BarrelHCAL_Sector_NoCombs_Union_Meshed.FCStd]
2024-05-04 add pfrich.lut, tof.lut, drich.lut
    The contents of "tof.info" were:
    ```
    Description of PID LUT's columns: (based on Roman's description)
    1) PDG code of the particle (e 11, pi 211, K 321, p 2212)
    2) charge (always 1), everything is symmetric in charge.
    3) momentum, [0.0,6.0] GeV in 20 bins (0.3 GeV steps).
    4) polar angle, [2.5, 154.6] in 18 bins (bin edge list: 2.50, 10.95, 19.40, 27.85, 36.30, 44.75, 53.20, 61.65, 70.10, 78.55, 87.00, 95.45, 103.90, 112.35, 120.80, 129.25, 137.70, 146.15, 154.60)
    5) azimuthal angle (always 0), everything is symmetric in azimuthal angle,
    6) probability for electron
    7) probability for pion
    8) probability for kaon
    9) probability for proton
    Probabilities are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
2024-05-06 updated tof.lut
    4) polar angle, [2.5, 154.6] in 18 bins (bin edge list: 2.50, 10.95,
    19.40, 27.85, 36.30, 44.75, 53.20, 61.65, 70.10, 78.55, 87.00, 95.45,
    103.90, 112.35, 120.80, 129.25, 137.70, 146.15, 154.60)
    5) azimuthal angle (always 0), everything is symmetric in azimuthal
    angle,
    Probabilities are normalized to 1.
    If all probabilities = 0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
2024-05-17 feat: import from wiki (link below)
    https://wiki.bnl.gov/EPIC/images/7/75/MARCO_v.7.6.2.2.11_1.7T_Magnetic_Field_Map_2024_05_02_rad_coords_%28mm%29_%28T%29.BMap.txt
2024-06-27 Update pfrich.lut using the new magnetic field MARCO_v.7.6.2.2.11_1.7T
2026-06-03 feat: add material map for curved OB
2026-07-27 new material map for epic/pull/1137
2026-08-13 New material map for epic/pull/1148
2026-10-18 material map: Add a map obtained w/ the "12-Sector-CyMBaL" branch of epic.
2026-10-24 New material map for the realistic B0 geometry (#42)
    Generated with scripts/material_map (1000x5000 geantinos,
    epic_craterlake_material_map) in eic-shell nightly.
2026-10-25 Material map for the 4 mm B0 exit window (eic/epic#1194) (#43)
    eic/epic 8ab03d5df builds the B0 exit window 4 mm thick instead of 8 mm
    (B0Win_thickness was passed to DD4hep Tube as a half-length). The window
    material is projected onto the first B0 approach surface, which the
    current map still has at 8 mm.
    epic_craterlake_material_map) in eic-shell nightly, on the eic/epic#1194
    geometry with the window fix.
    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
2026-11-07 fix: add Vacuum material definition to SVTOB gdml files
    The files referenced materialref ref="Vacuum" without defining it,
    causing GDML validation errors.
